CMHASD/CrayStation_MicroObservatory/Overview & Notes/CrayStation Schematic.jpg

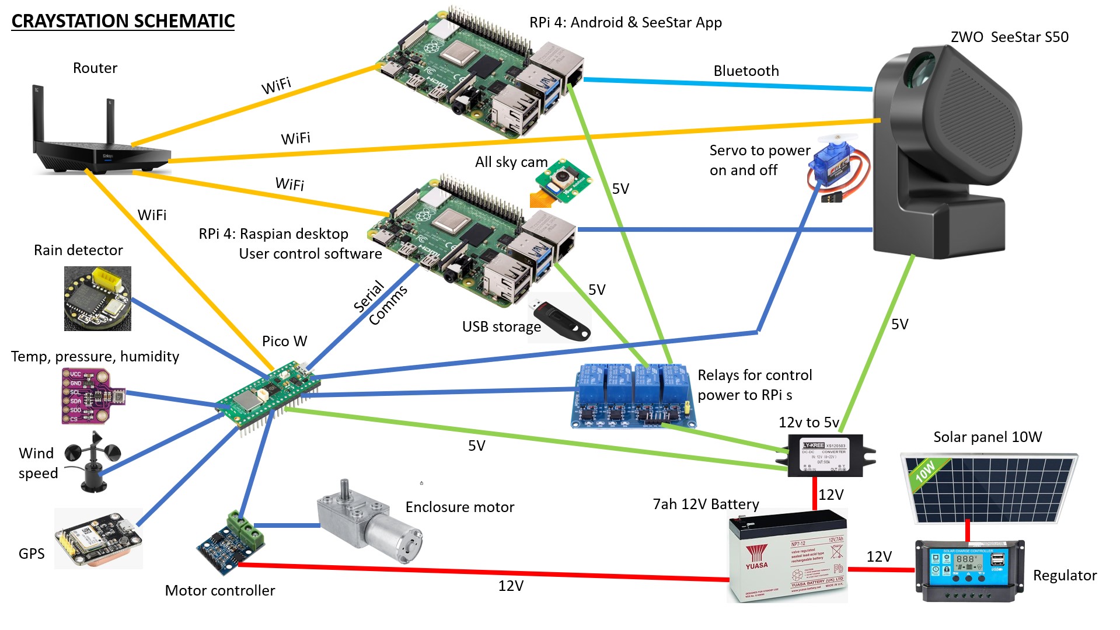
Overview & Notes/CrayStation Schematic.jpg
