CMHASD/CrayStation_MicroObservatory/Source Code/Craystation Python/Stellarium.png

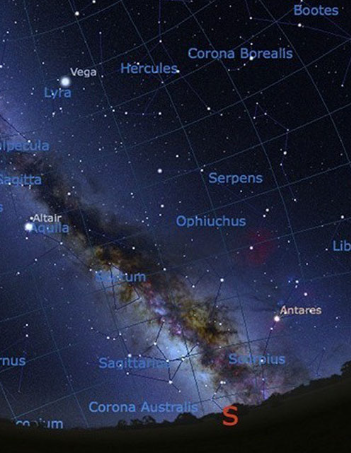
Source Code/Craystation Python/Stellarium.png
