CMHASD/CrayStation_MicroObservatory/README.md

# CrayStation Micro Observatory

## STATUS

This is a work in progress, it has not been tested and is unlikely to work.

## Concept

Develop a solar powered, micro-observatory requiring no intervention from the host site to operate on a Night by Night Basis. The only requirement for the remote site is a flat surface and a Wifi connection.

The project will be split into a number of parts, which together will form the CrayStation Micro Observatory.

1.  A powered, opening enclosure, remotely controlled.
2.  A Seestar S50 smart telescope, remotely controlled.
3.  An all-sky camera, scripted and remotely controlled.
4.  Weather station, remotely controlled.
5.  Host User Interface, controlled locally, viewable remotly.
6.  Solar Panel charging and battery charging circuit 
7.  Security - Authentication and management of remote users, no 'reverse' access into hosts network.

The overall Package will be designed to be built and then delivered to site.

## Constraints

These constraints cover the whole project, other constraint may exist for the individual modules 

1.  **Power** - _There will be a power budget - to be defined_
2.  **Usability** - _The CrayStation will be easy to use for the Host and Remote User._
3. **Small Footprint** -_The project will take up a small amount of space so as to minimise the impact on the host site._
4.  **Multiple Users** - _The project will be designed for multiple remote users_
5.  **Unreliable Wifi** - _The project will assume the wifi is unreliable, slow and dynamically sets the IP address._
6.  **Budget** - _This is meant to be acheivable for a modest budget of under £1000_

## Definitions

**HostUser**:  The friend or relative who will host the CrayStation on their property.\
**RemoteAdmin**: The Person, remote from the observing site responsible for administration of the CrayStation Micro Observatory\
**RemoteObserver**: The Person Using the CrayStation Micro Observatory
