CMHASD/CrayStation_MicroObservatory/AllSkyCamera/README.MD

# All Sky Camera

## Purpose

The AllSky Camera is designed primarialy to assess the cloud cover for an observing session, so the user can decide if it is worth observing or not. A side effect will be the potential to build timelapses of the night, star trails, cloud cover graphs etc.
