CMHASD/CrayStation_MicroObservatory/SeeStarRemoteControl/README.MD

# Android 13 for the Raspberry Pi 4

Follow this YouTube guide to install Android 13 onto an SD card for the Raspberry Pi.
  https://www.youtube.com/watch?v=reuH6NEk6B4

Window users should use Disk Genius to increase the EXT4 partition to fully use the space on the SD Card for the Android 13 storage environment.
  https://www.diskgenius.com/

Following the guide allows Google Play to be installed and the SeeStar Android App to be downloaded.  The environmoent acts like an Android Tablet.

Details of the Android 13 image can be found here:
  https://konstakang.com/devices/rpi4/AOSP13/

Lite Apps here:
  https://sourceforge.net/projects/litegapps/files/

Get the Device ID for Google here
  https://www.apkmirror.com/apk/evozi/device-id/device-id-1-3-2-release/device-id-1-3-2-android-apk-download/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

Register with Google here:
  https://www.google.com/android/uncertified/

KR 23 Sep 2024
