CMHASD/CrayStation_MicroObservatory/Enclosure/README.MD

### CrayStation Micro Observatory - Enclosure
