CMHASD/CrayStation_MicroObservatory/Source Code/Design Docs/Lid Motor Control.pdf

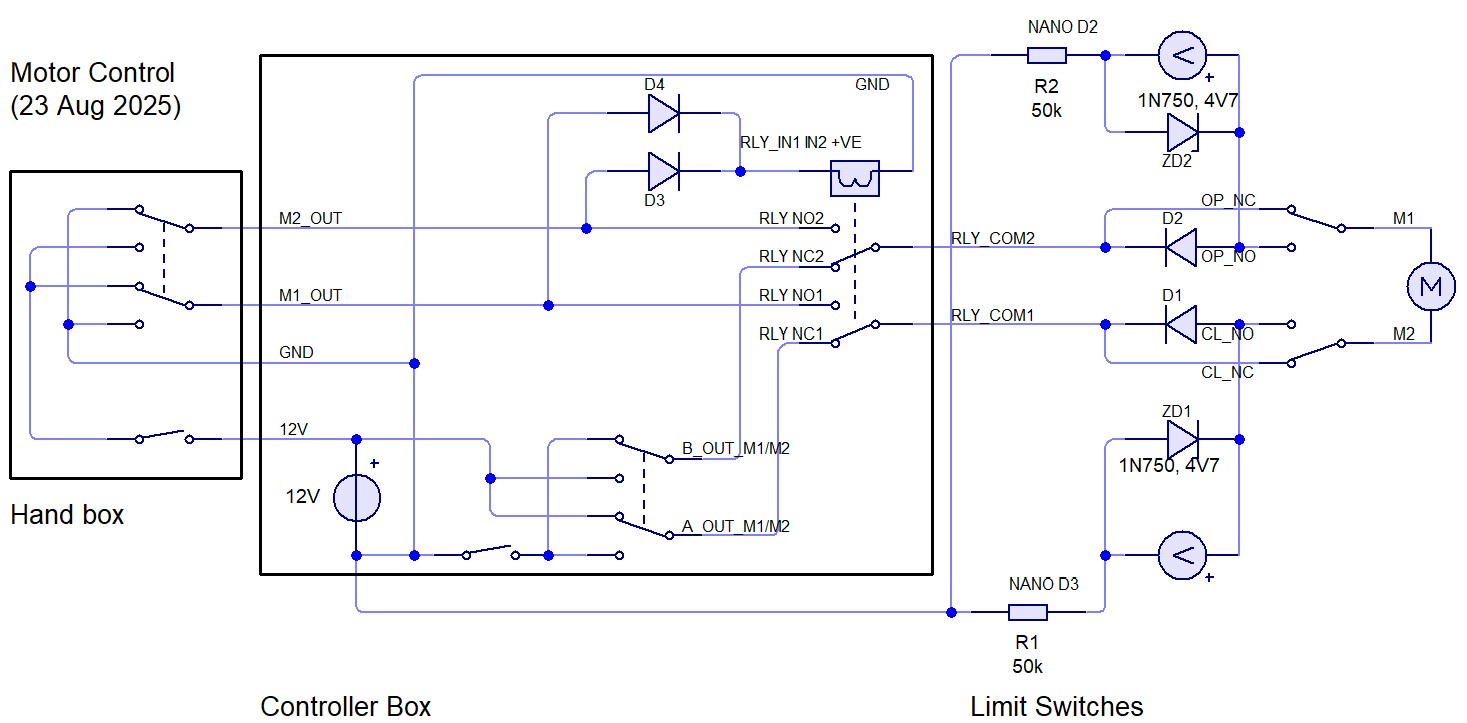
[picture p3: page 1]
