CMHASD/CrayStation_MicroObservatory/Overview & Notes/high level SW Block Diagram.png

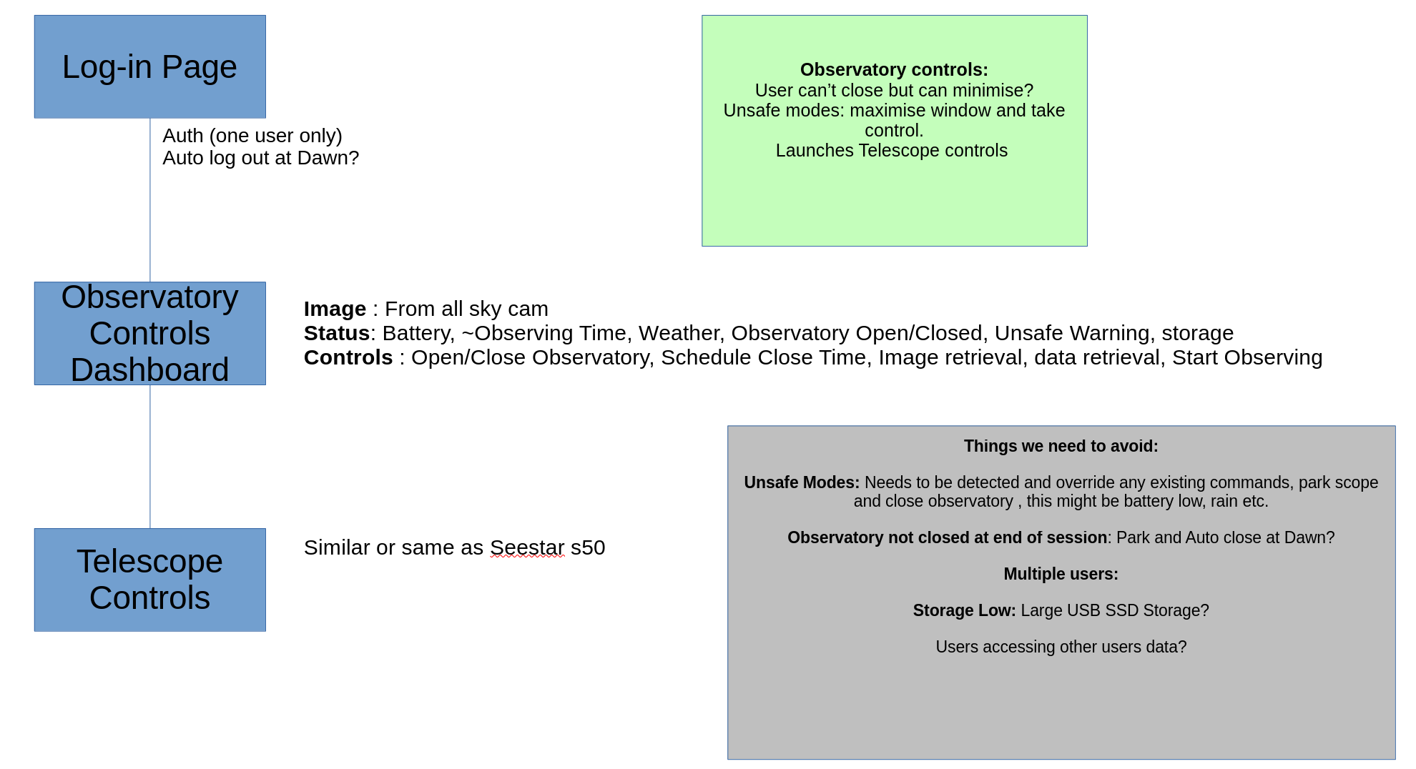
Overview & Notes/high level SW Block Diagram.png
