CMHASD/CrayStation_MicroObservatory/Source Code/Craystation Python/AllSkyCam.png

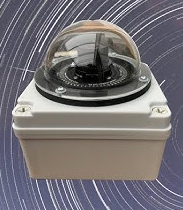
Source Code/Craystation Python/AllSkyCam.png
