CMHASD/CrayStation_MicroObservatory/Source Code/Craystation Python/File manager.png

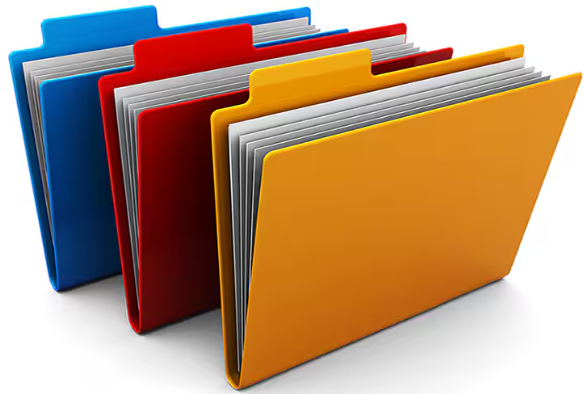
Source Code/Craystation Python/File manager.png
