CMHASD/CrayStation_MicroObservatory/Source Code/Craystation Python/Seestar.png

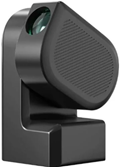
Source Code/Craystation Python/Seestar.png
