CMHASD/CrayStation_MicroObservatory/Source Code/Craystation Python/skycam.jpg

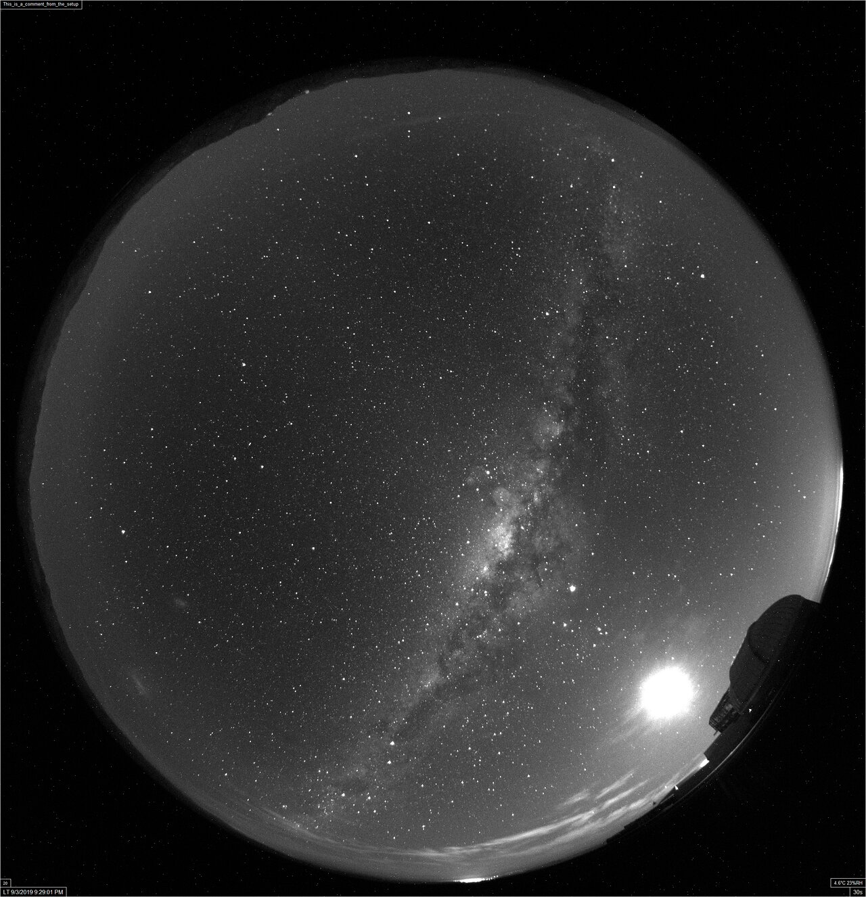
Source Code/Craystation Python/skycam.jpg
