CMHASD/CrayStation_MicroObservatory/Enclosure/ControlBoard PCB Schematic.pdf

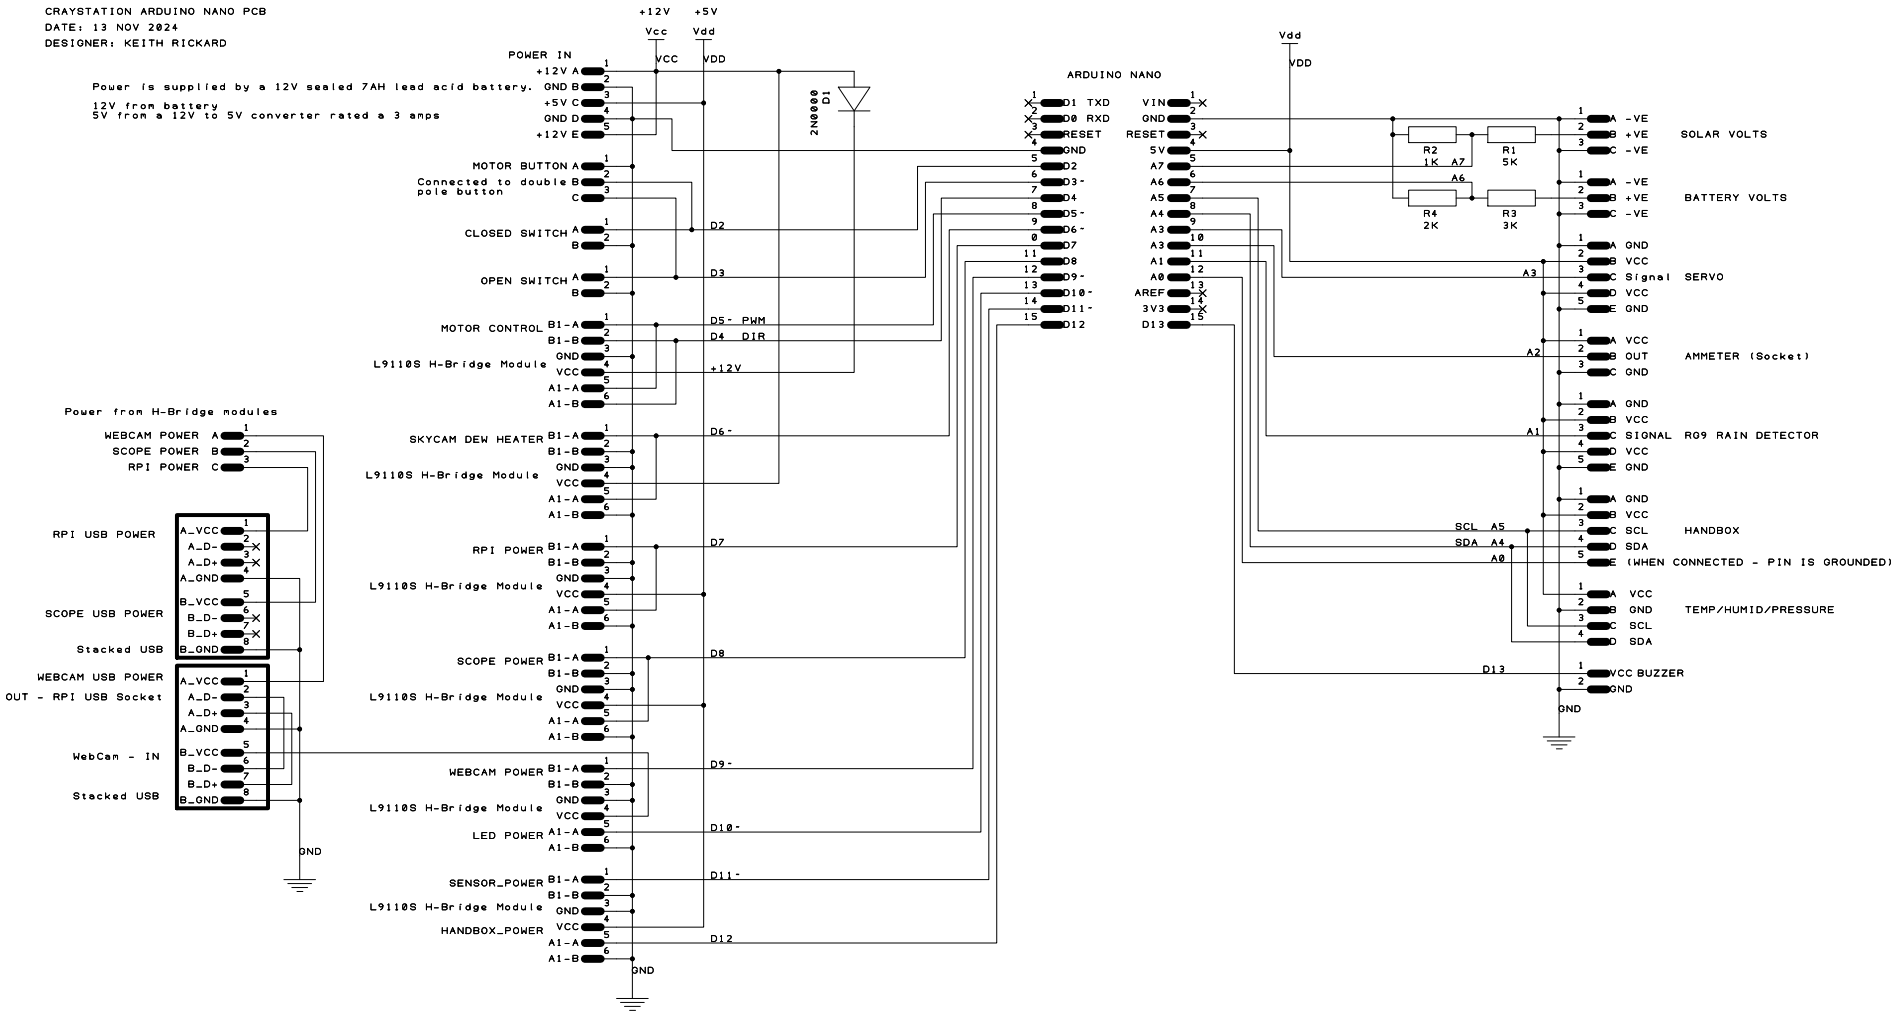
[picture p9: page 1]
