CMHASD/CrayStation_MicroObservatory/Source Code/Design Docs/ControlBoard - PCB Silk.pdf

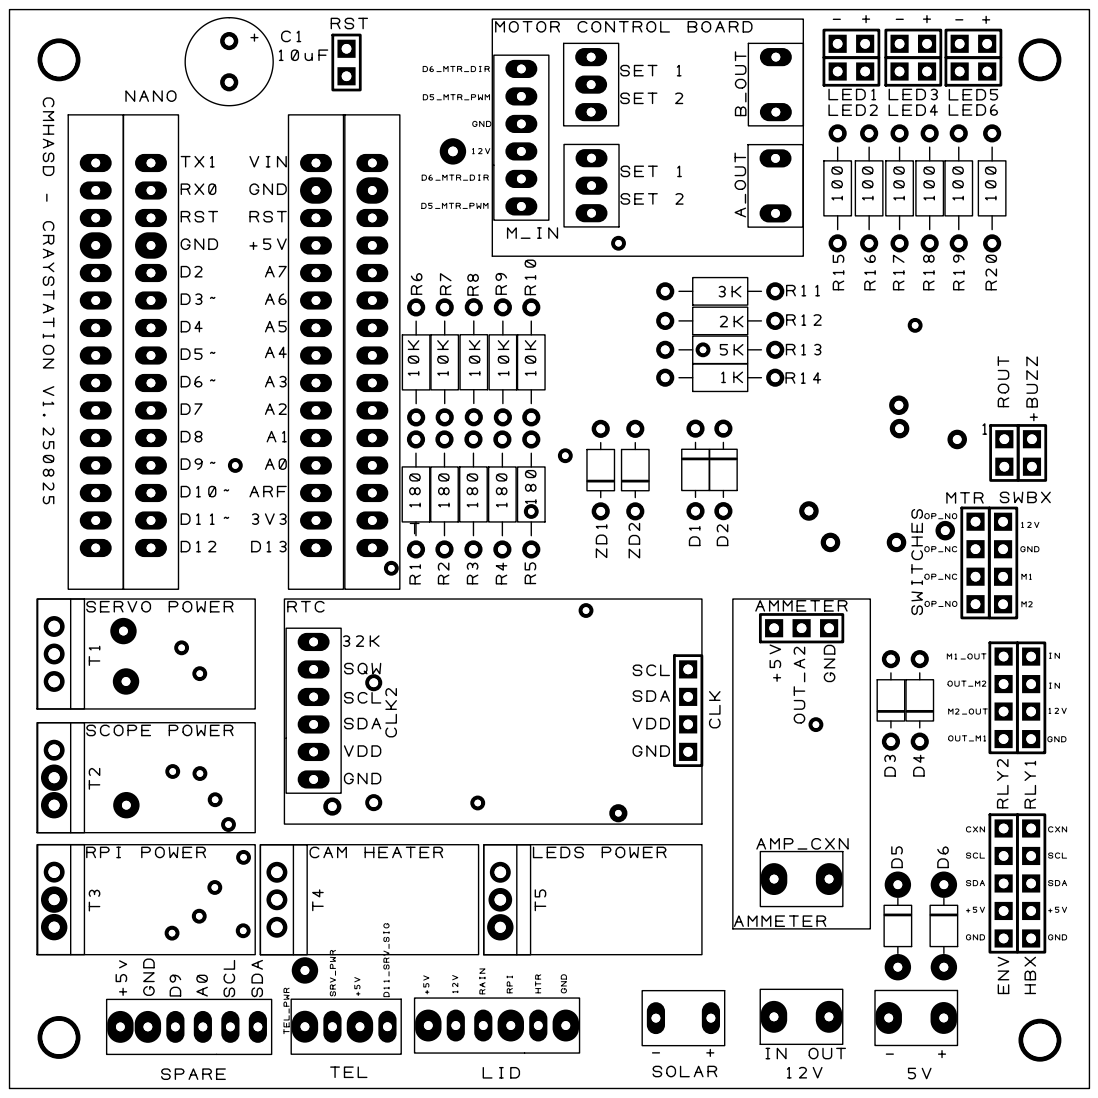
[picture p10: page 1]
