CMHASD/CrayStation_MicroObservatory/Source Code/Design Docs/ControlBoard Schematic.pdf

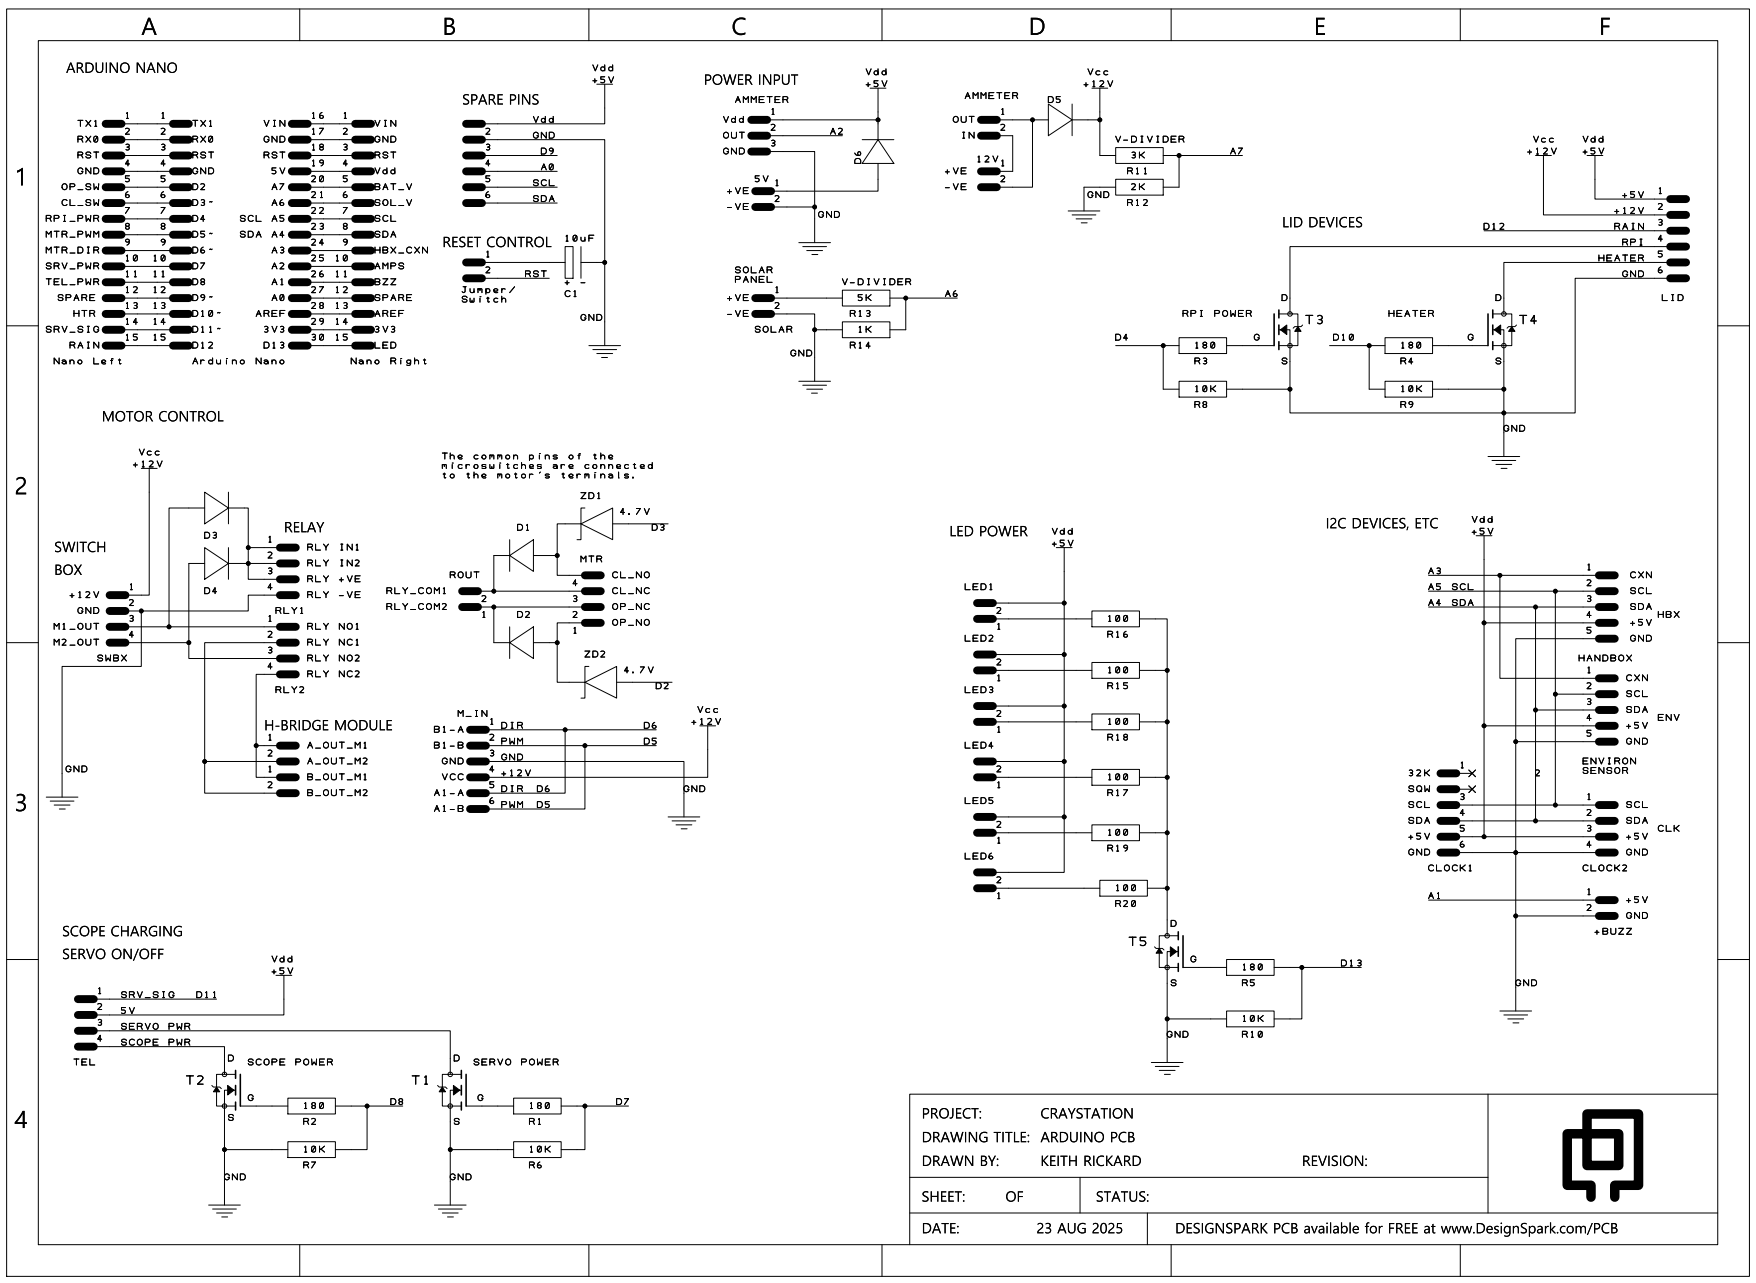
[picture p11: page 1]
