CMHASD/CrayStation_MicroObservatory/(list of files, drawings)

Other design files:
Source Code/DesignSpark/ControlBoard.pcb
Source Code/DesignSpark/~ControlBoard.pcb
