CMHASD/CrayStation_MicroObservatory/(commit log)

2024-12-16 Arduino Source Code
2024-12-16 Design Spark Files V0.241216
    [ControlBoard.pcb, ControlBoard.sch]
2025-10-12 Arduino code V0.251012
2025-10-15 Version V0.250920
    [ControlBoard.pcb, ControlBoard.sch, ~ControlBoard.pcb]
